JamisonHood/Haptic-Paddle/README.md

# Haptic-Paddle

The haptic paddle is a low cost haptic feedback device intended to be used in STEM education.
