JamisonHood/Haptic-Paddle/STEP Files/LCD Plate.step

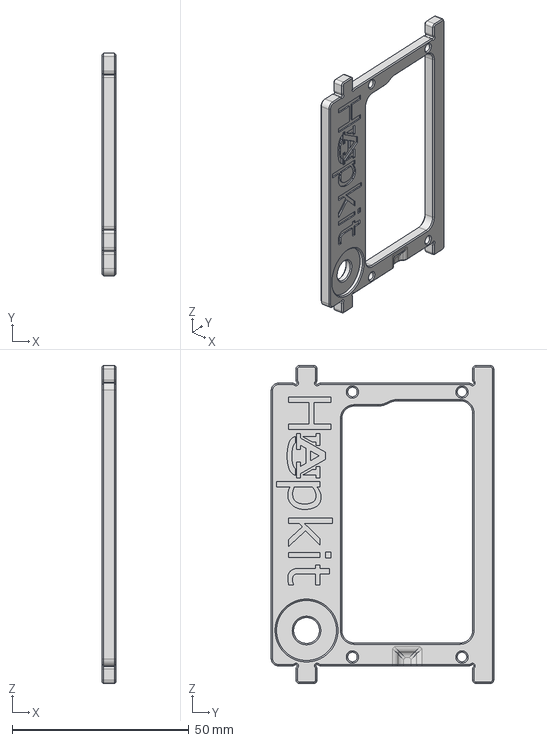
[picture p1: CAD file, 2023-11-12]
STEP Files/LCD Plate.step
4.00 x 63.0 x 90.0 mm
