JamisonHood/Haptic-Paddle/STEP Files/Left Side Plate.step

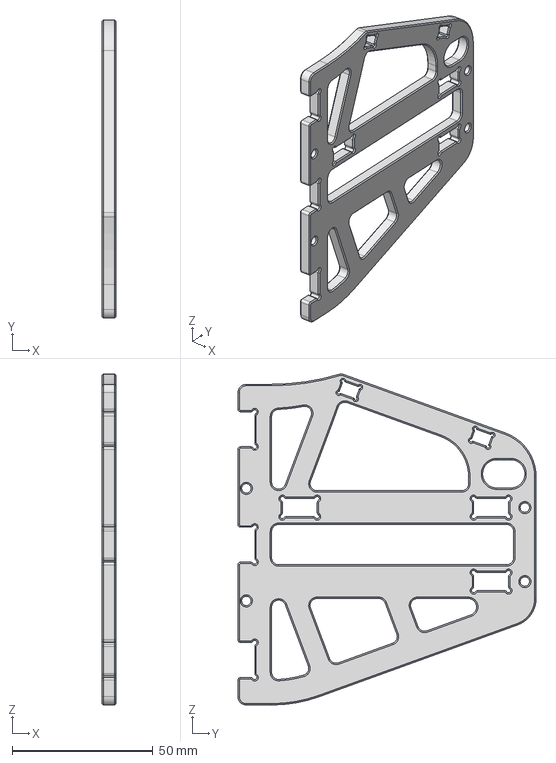
[picture p2: CAD file, 2023-11-12]
STEP Files/Left Side Plate.step
5.00 x 106.0 x 117.6 mm
