JamisonHood/Haptic-Paddle/STEP Files/Support Plate.step

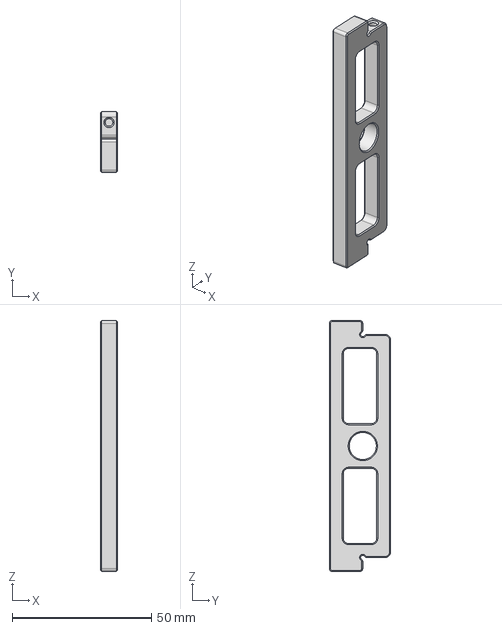
[picture p3: CAD file, 2023-11-12]
STEP Files/Support Plate.step
6.00 x 22.0 x 90.0 mm
