JamisonHood/Haptic-Paddle/STEP Files/Motor Plate (90 Deg).step

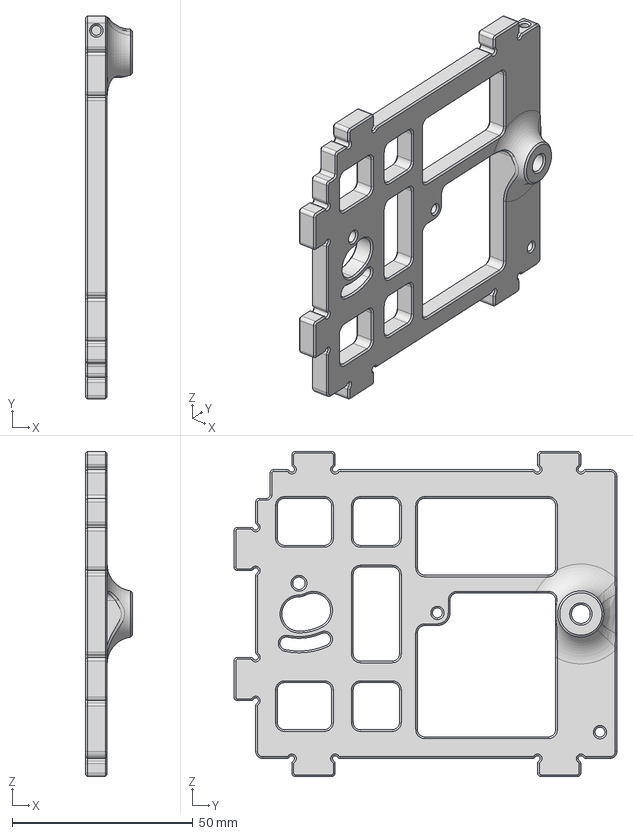
[picture p4: CAD file, 2023-11-12]
STEP Files/Motor Plate (90 Deg).step
13.0 x 106.0 x 90.0 mm
