JamisonHood/Haptic-Paddle/STEP Files/Motor Pulley.step

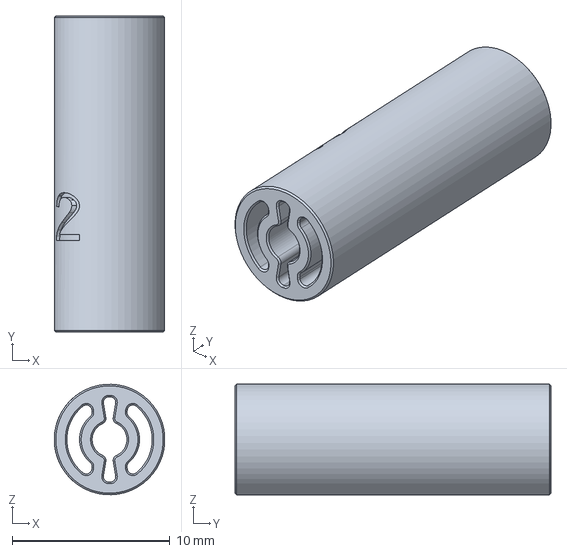
[picture p5: CAD file, 2023-11-12]
STEP Files/Motor Pulley.step
6.99 x 20.0 x 7.00 mm
