JamisonHood/Haptic-Paddle/STEP Files/Swing Arm.step

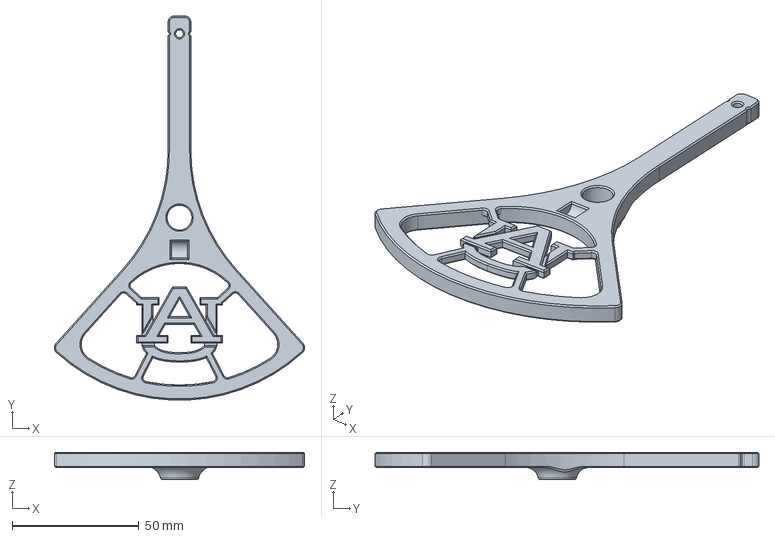
[picture p6: CAD file, 2023-11-12]
STEP Files/Swing Arm.step
98.7 x 151.4 x 10.8 mm
