JamisonHood/Haptic-Paddle/STEP Files/Bottom Plate.step

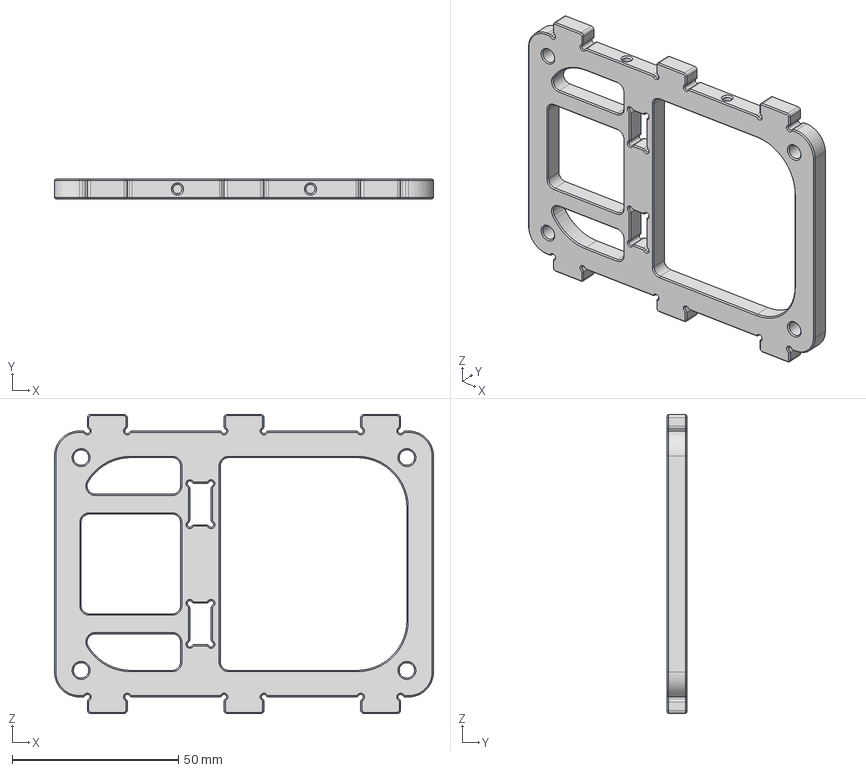
[picture p7: CAD file, 2023-11-12]
STEP Files/Bottom Plate.step
114.0 x 6.00 x 90.0 mm
