JamisonHood/Haptic-Paddle/STEP Files/Right Side Plate.step

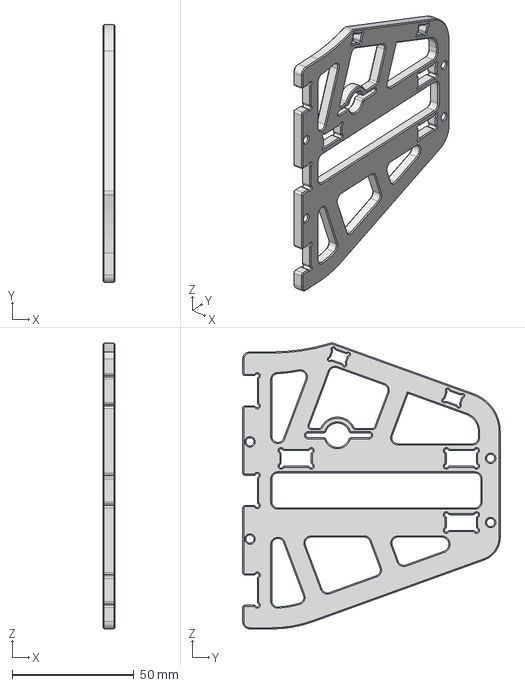
[picture p8: CAD file, 2023-11-12]
STEP Files/Right Side Plate.step
5.00 x 106.0 x 117.7 mm
