JamisonHood/Haptic-Paddle/Haptic Paddle Assembly Instructions.pdf

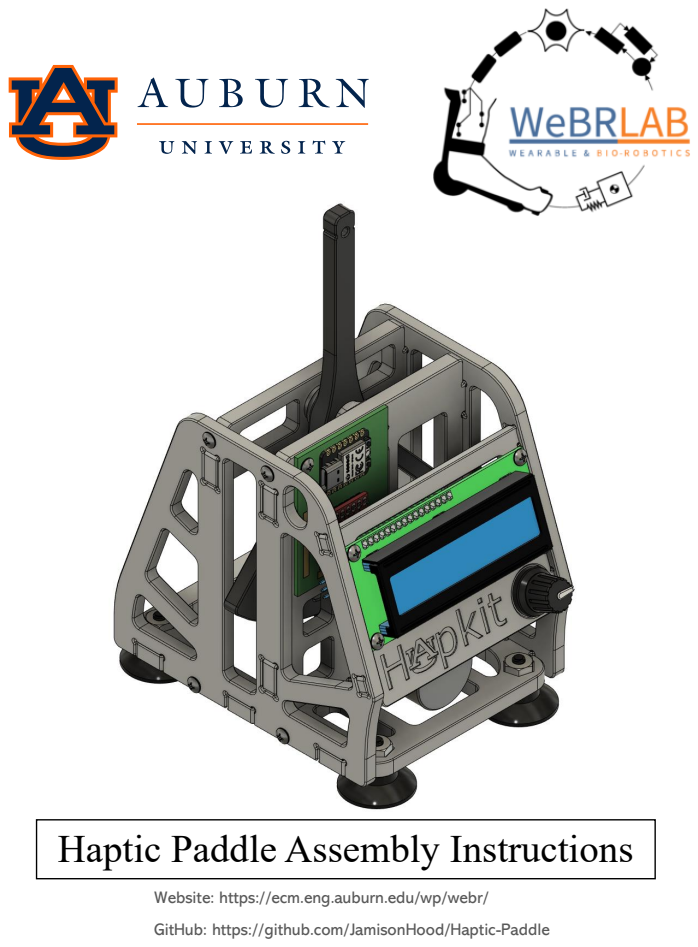
[picture p9: page 1]

Haptic Paddle Assembly Instructions

Website: https://ecm.eng.auburn.edu/wp/webr/

GitHub: https://github.com/JamisonHood/Haptic-Paddle

P a g e | 2

## Table of Contents

Required Components | 3
Electronics | 3
Hardware | 4
3D printed Components | 6
Assembly Steps | 9
1 | 9
2 | 9
3 | 10
4 | 10
5 | 11
6 | 11
7 | 12
8 | 12
9 | 13
10 | 13
11 | 14
12 | 14
13 | 15
14 | 15
15 | 16
16 | 16
17 | 17
18 | 17
19 | 18
20 | 18

## Required Components

## Electronics

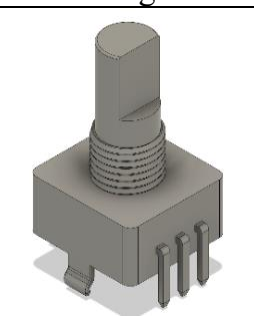
[picture p10: figure]

Part Name | Quantity | Image
Rotary Encoder | 1

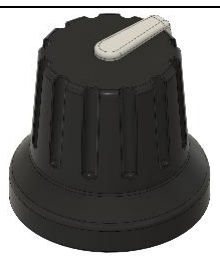
[picture p11: figure]

Encoder Knob | 1

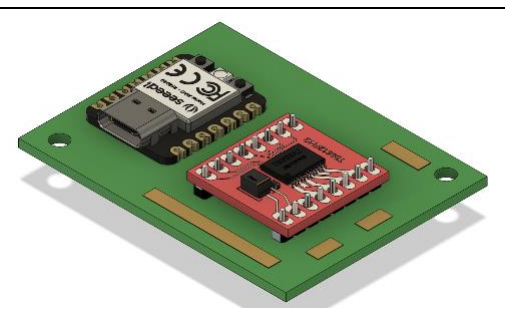
[picture p12: figure]

Control Board | 1

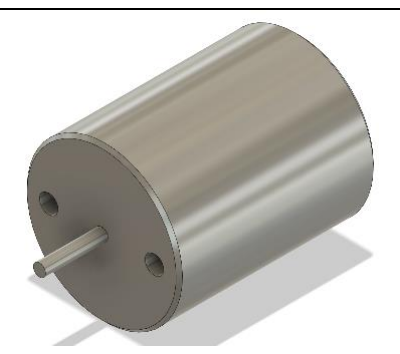
[picture p13: figure]

Brushed Motor | 1

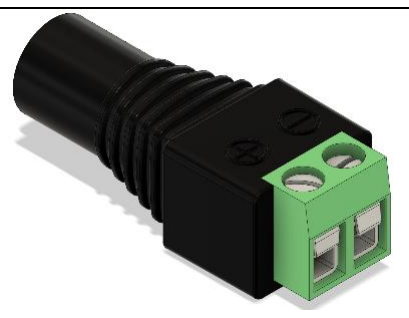
[picture p14: figure]

Barrel Power Connector | 1

LCD Display | 1

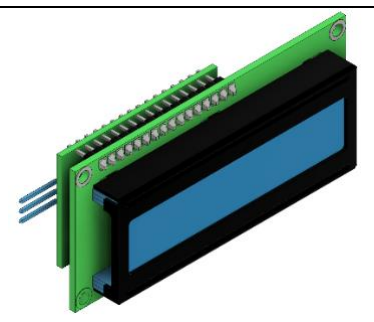
[picture p15: figure]

## Hardware

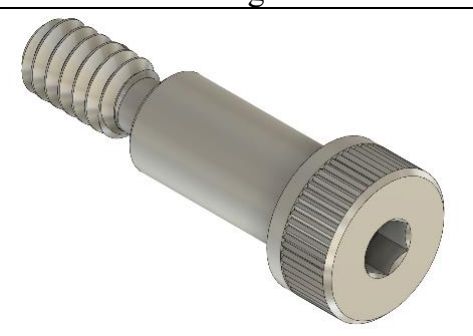
[picture p16: figure]

Part Name | Quantity | Image
¼ Inch Shoulder Bolt | 1

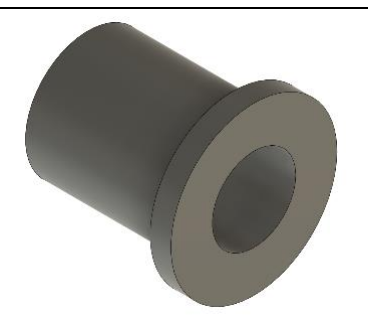
[picture p17: figure]

¼ Inch Sleeve Bushing | 1

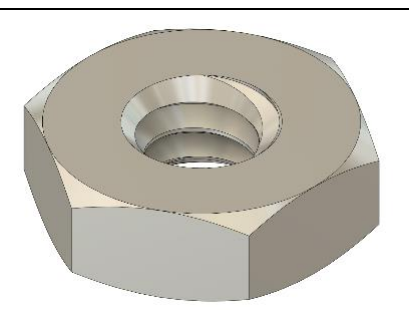
[picture p18: figure]

10-24 Nut (For Shoulder Bolt) | 1

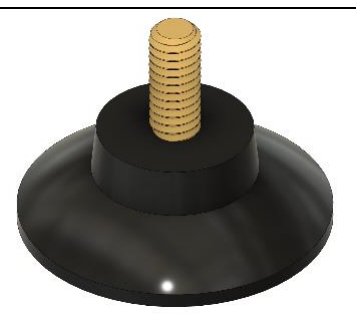
[picture p19: figure]

Rubber Feet | 4

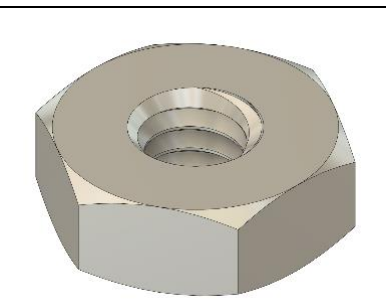
[picture p20: figure]

8-32 Nut (For Rubber Feet) | 4

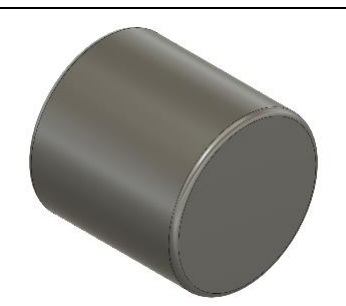
[picture p21: figure]

Disc Magnet | 1

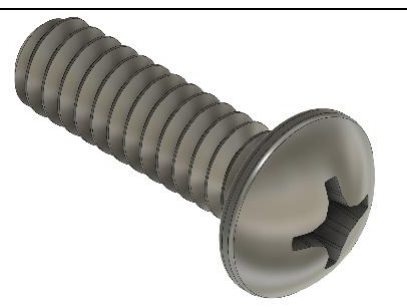
[picture p22: figure]

18-8 Pan Head Screw | 16

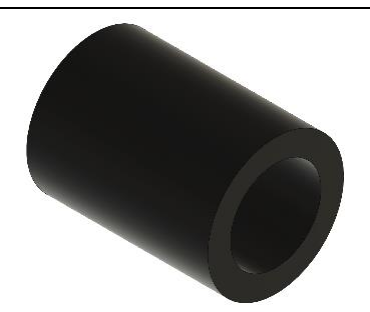
[picture p23: figure]

Rubber Sleeve | 1

## 3D printed Components

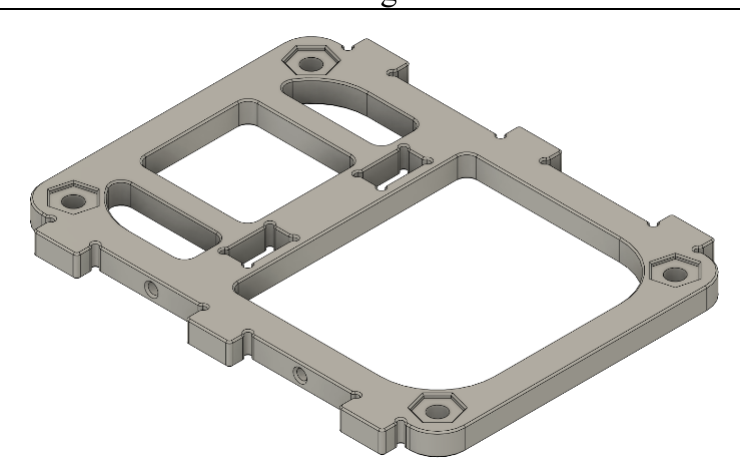
[picture p24: figure]

Part Name | Quantity | Image
Base Plate | 1

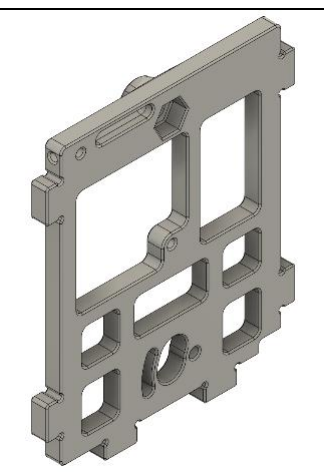
[picture p25: figure]

Motor and Electronics Plate | 1

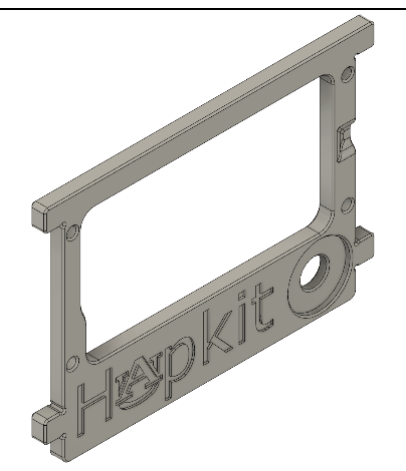
[picture p26: figure]

LCD Frame | 1

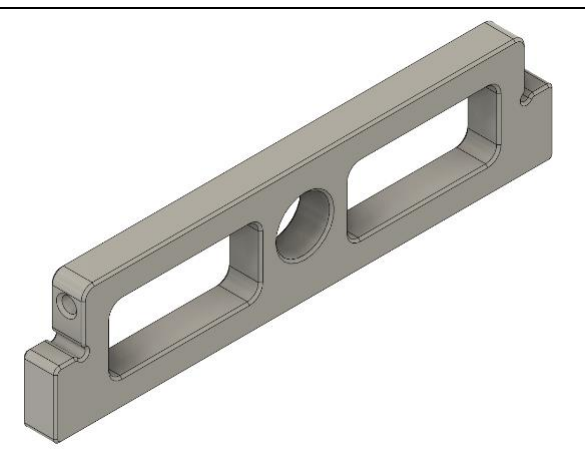
[picture p27: figure]

Shoulder Support Plate | 1

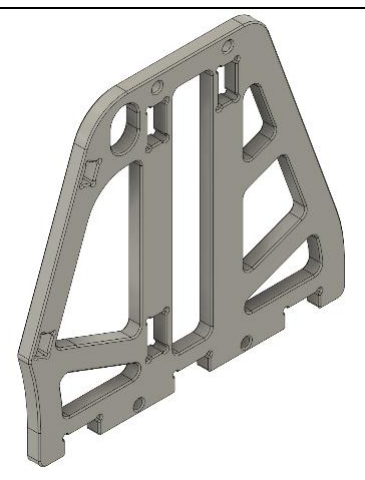
[picture p28: figure]

Left Side Plate | 1

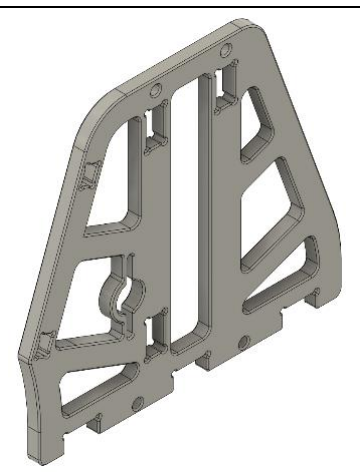
[picture p29: figure]

Right Side Plate | 1

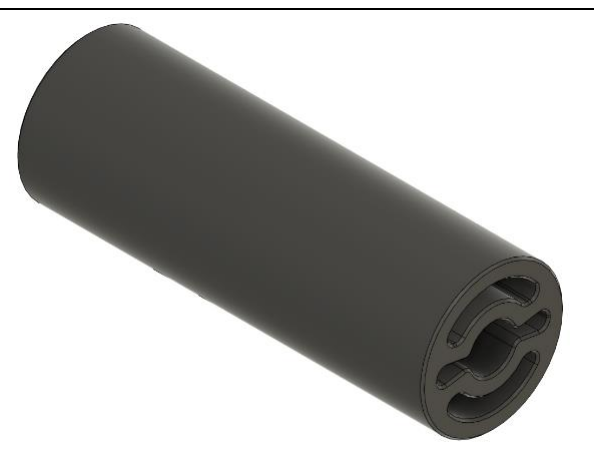
[picture p30: figure]

Motor Pulley | 1

P a g e |

8

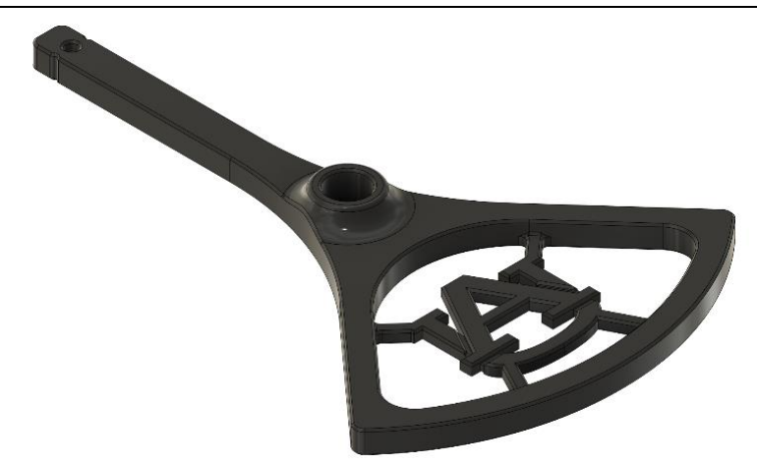
[picture p31: figure]

Paddle
1

1 | Assembly Steps

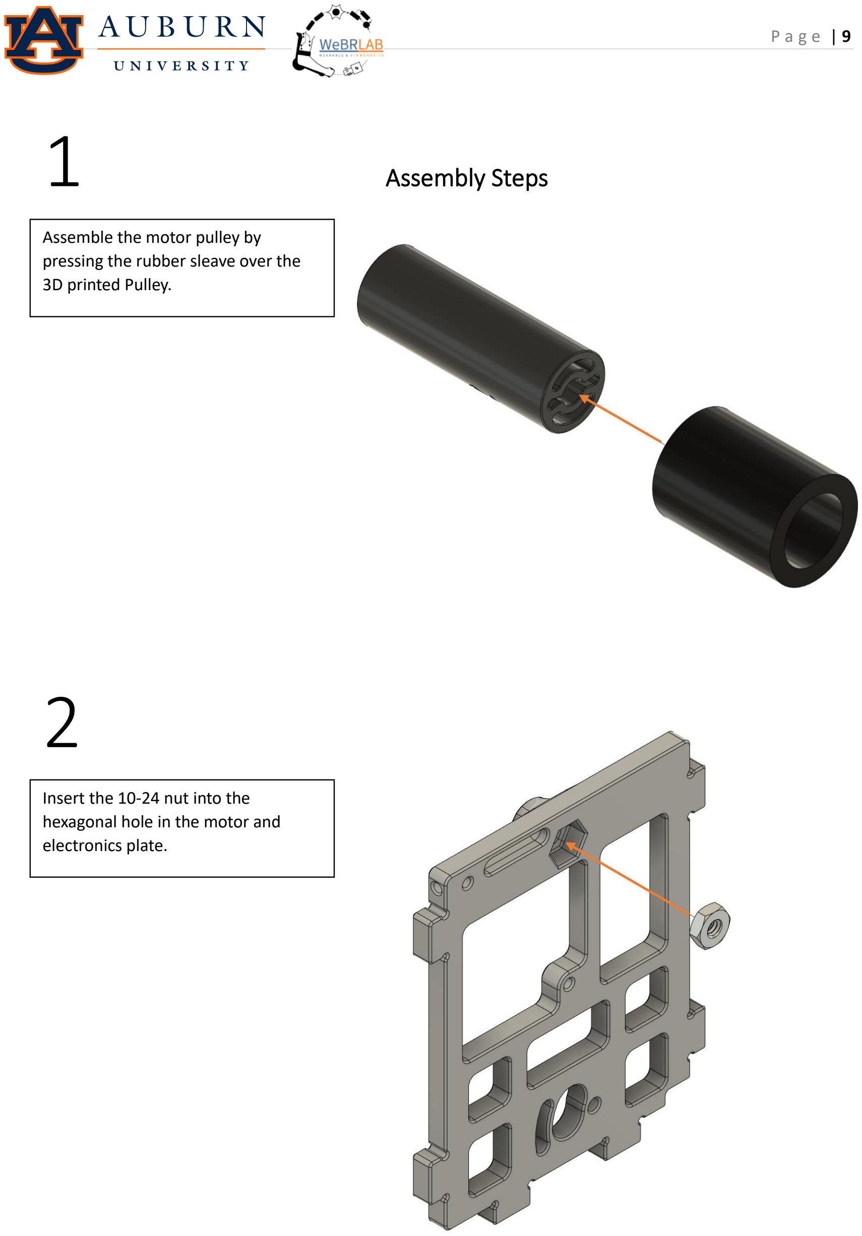
[picture p32: page 9]

2

Assemble the motor pulley by pressing the rubber sleave over the 3D printed Pulley.

Insert the 10-24 nut into the hexagonal hole in the motor and electronics plate.

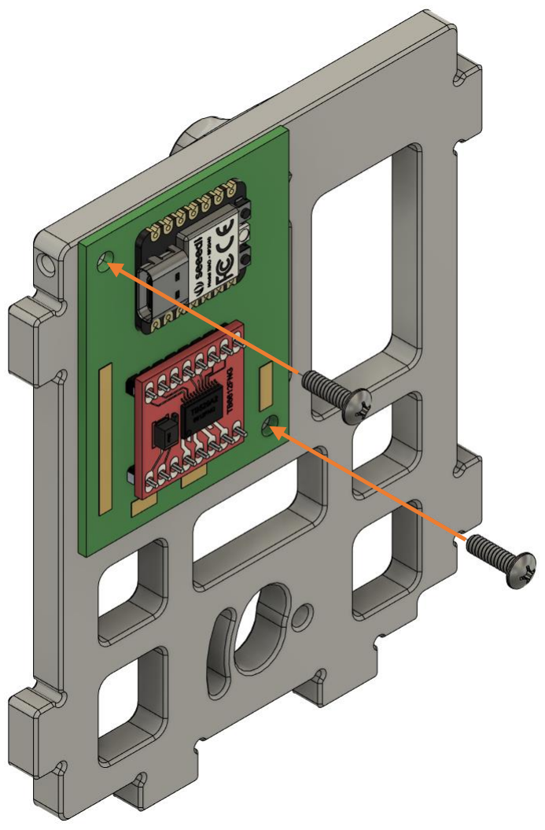
[picture p33: figure]

3

4

Attach the electronics PCB using 2 #18-8 Screws.

Note: Make sure the #10-24 nut is in place as it will not be accessible after this step.

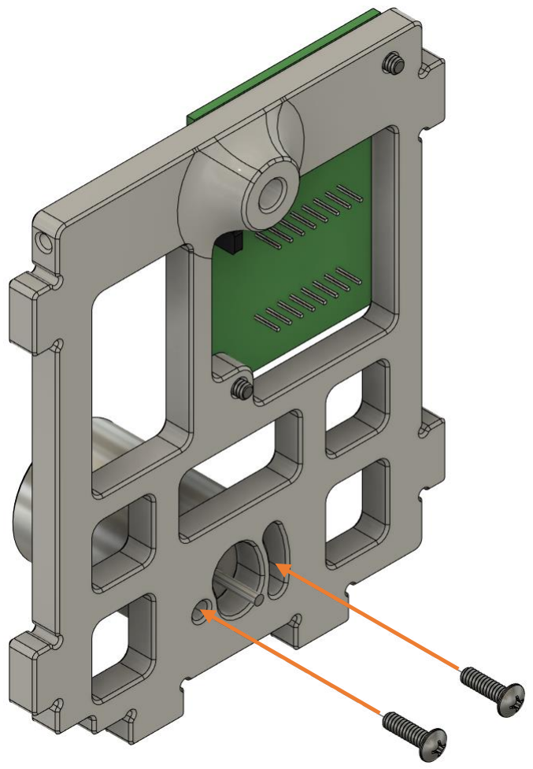
[picture p34: figure]

Attach the brushed motor using 2 #18-8 screws. Leave the screws loose such that the motor can freely swing in its mount.

5

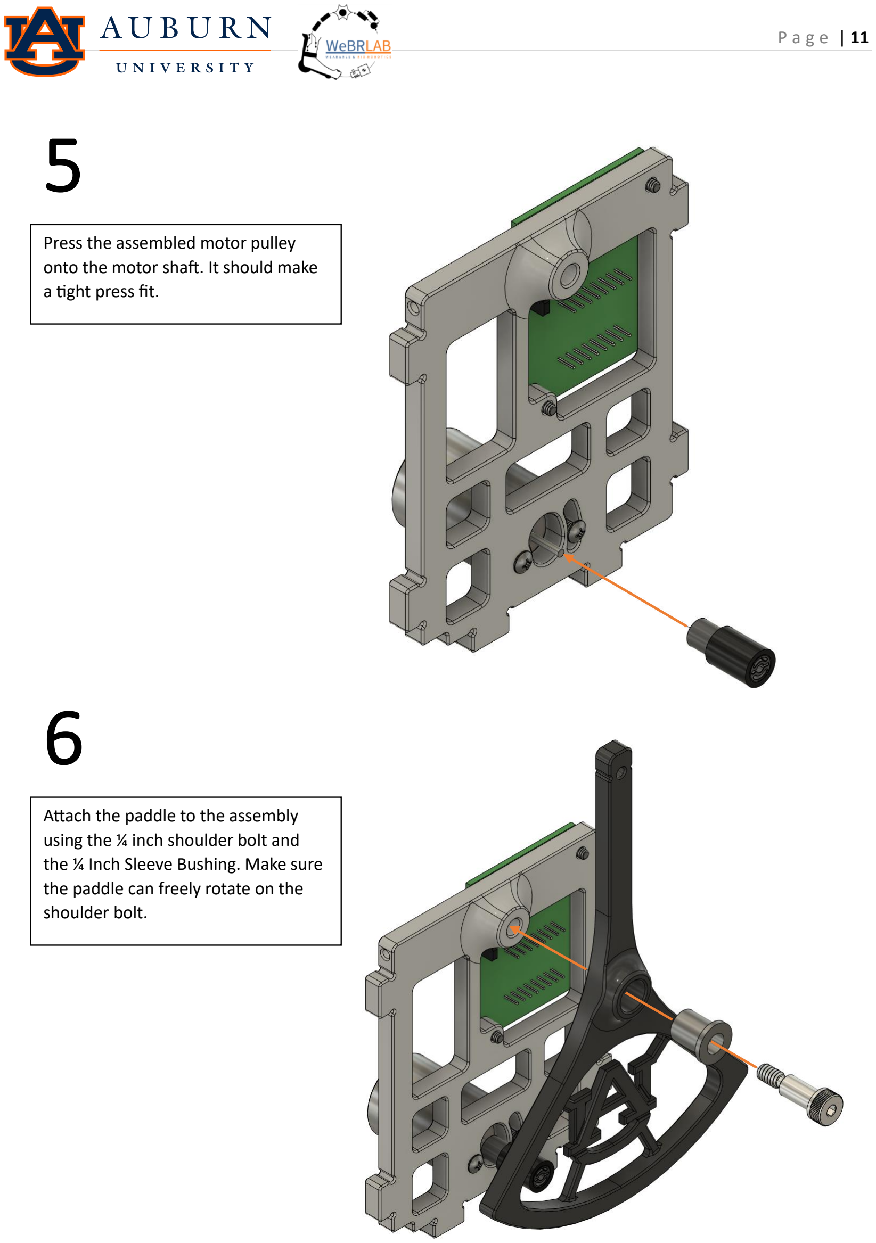
[picture p35: page 11]

6

Press the assembled motor pulley onto the motor shaft. It should make a tight press fit.

Attach the paddle to the assembly using the ¼ inch shoulder bolt and the ¼ Inch Sleeve Bushing. Make sure the paddle can freely rotate on the shoulder bolt.

7

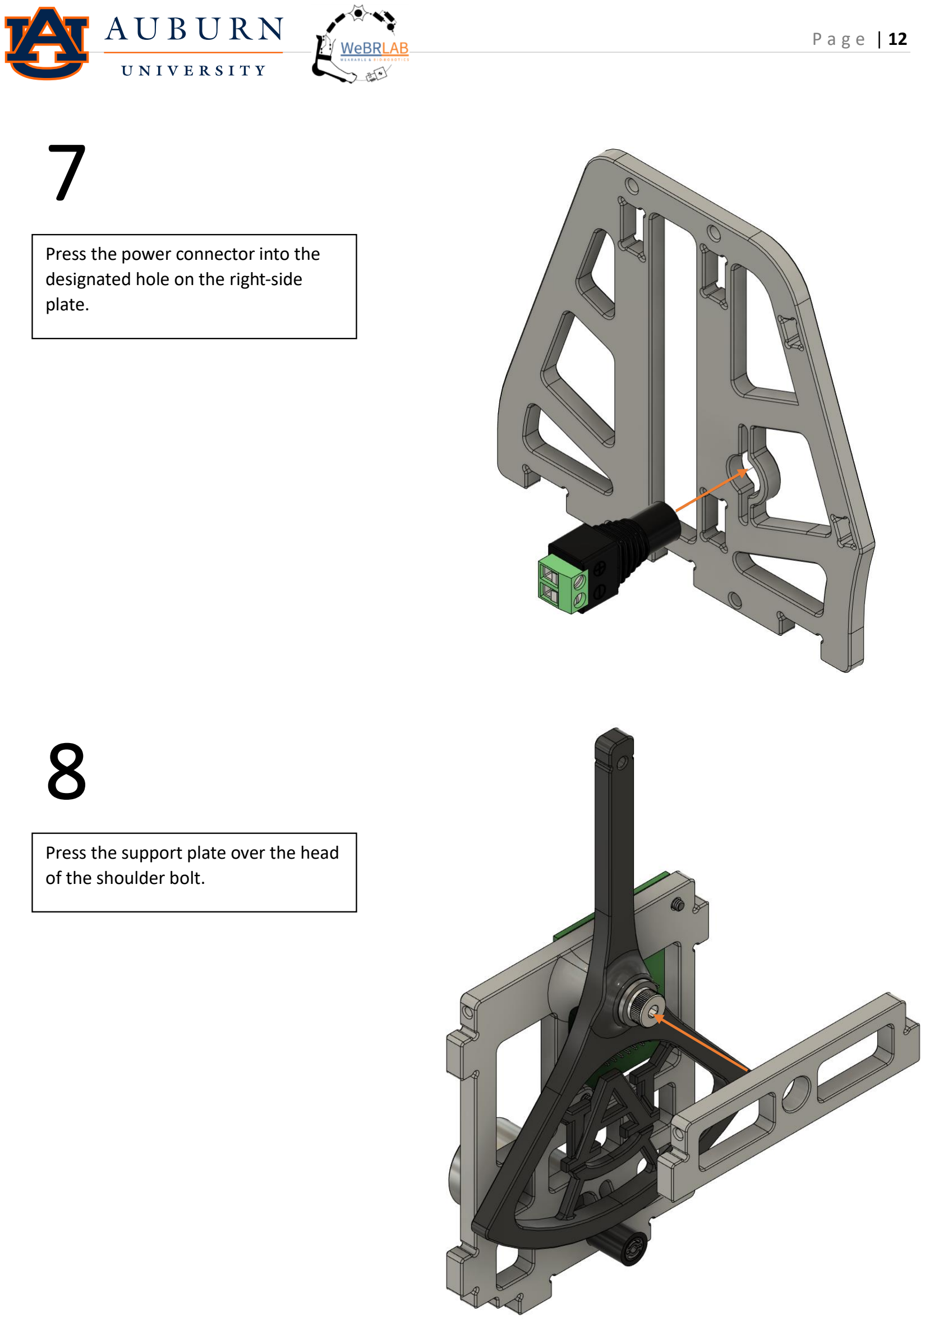
[picture p36: page 12]

8

Press the power connector into the designated hole on the right-side plate.

Press the support plate over the head of the shoulder bolt.

9

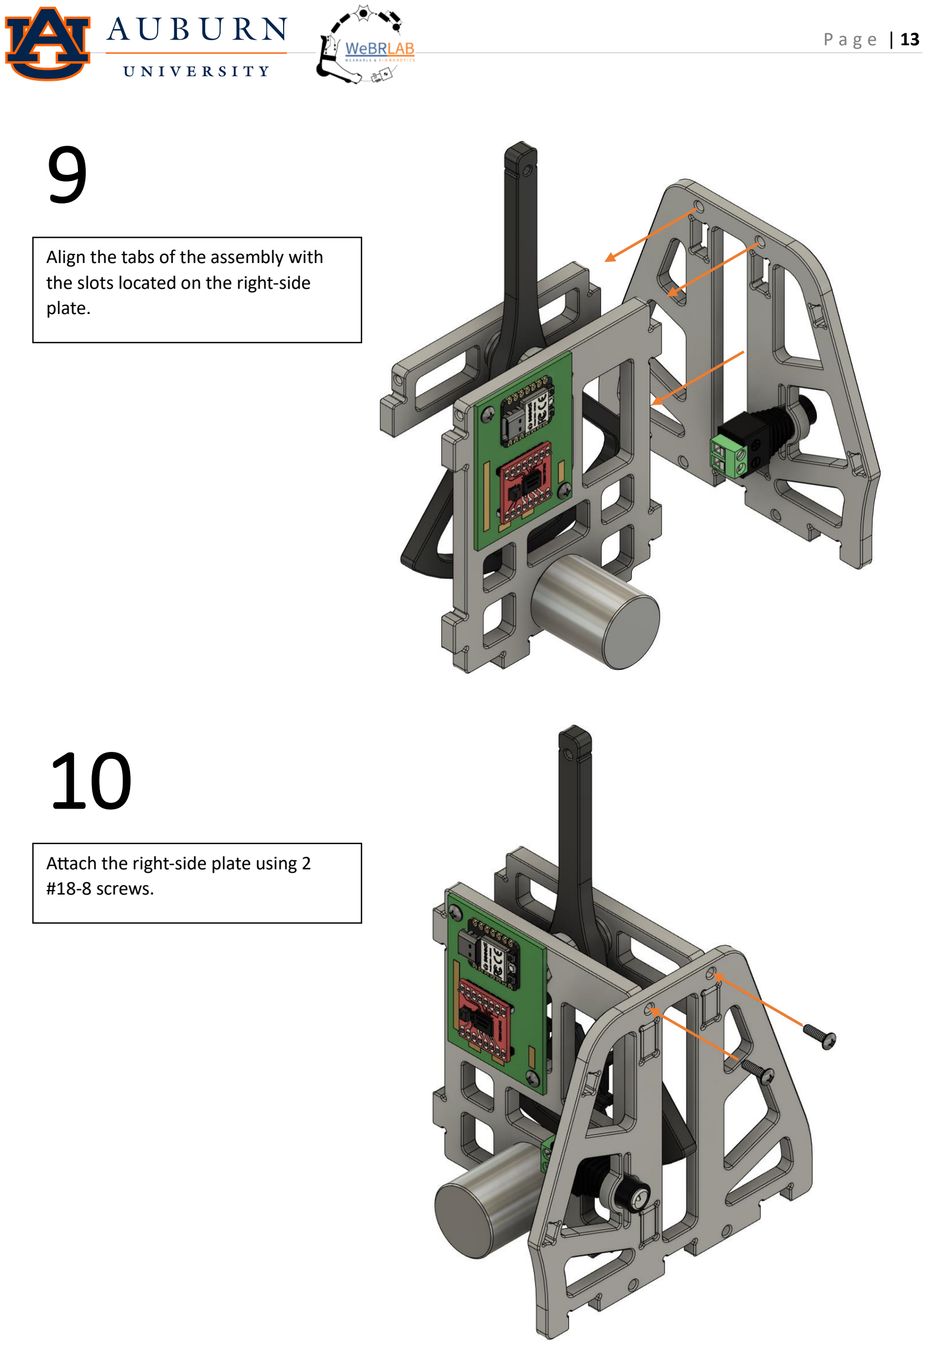
[picture p37: page 13]

10

Align the tabs of the assembly with the slots located on the right-side plate.

Attach the right-side plate using 2 #18-8 screws.

11

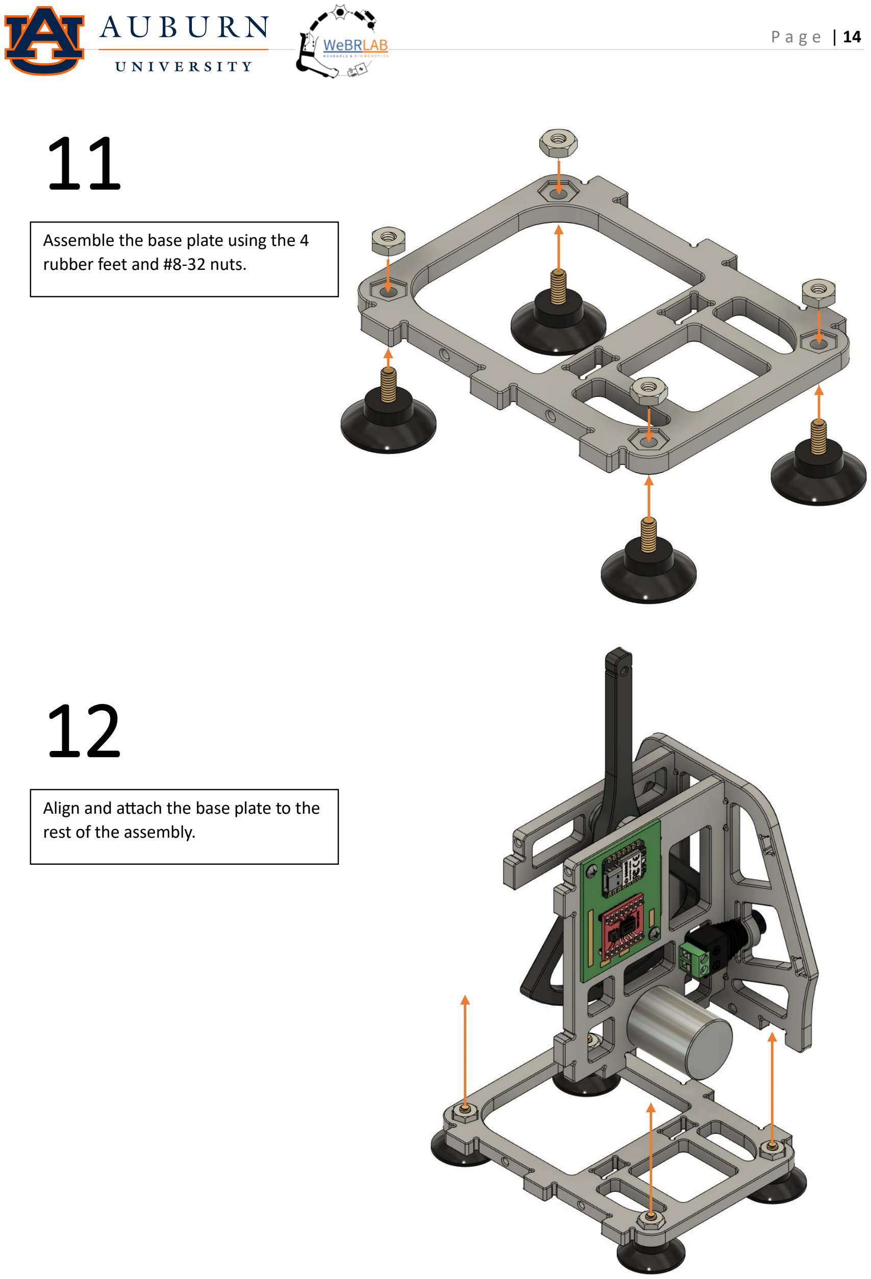
[picture p38: page 14]

12

Assemble the base plate using the 4 rubber feet and #8-32 nuts.

Align and attach the base plate to the rest of the assembly.

13

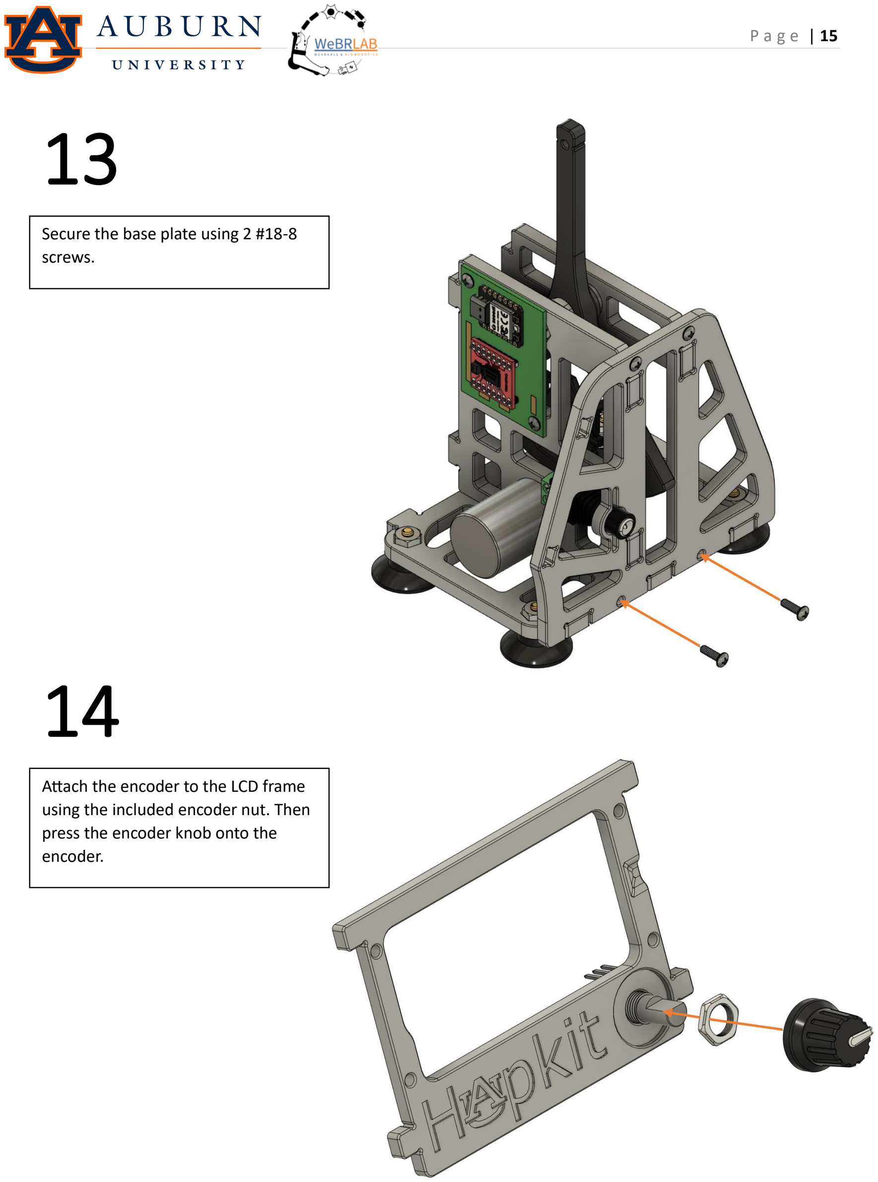
[picture p39: page 15]

14

Secure the base plate using 2 #18-8 screws.

Attach the encoder to the LCD frame using the included encoder nut. Then press the encoder knob onto the encoder.

15

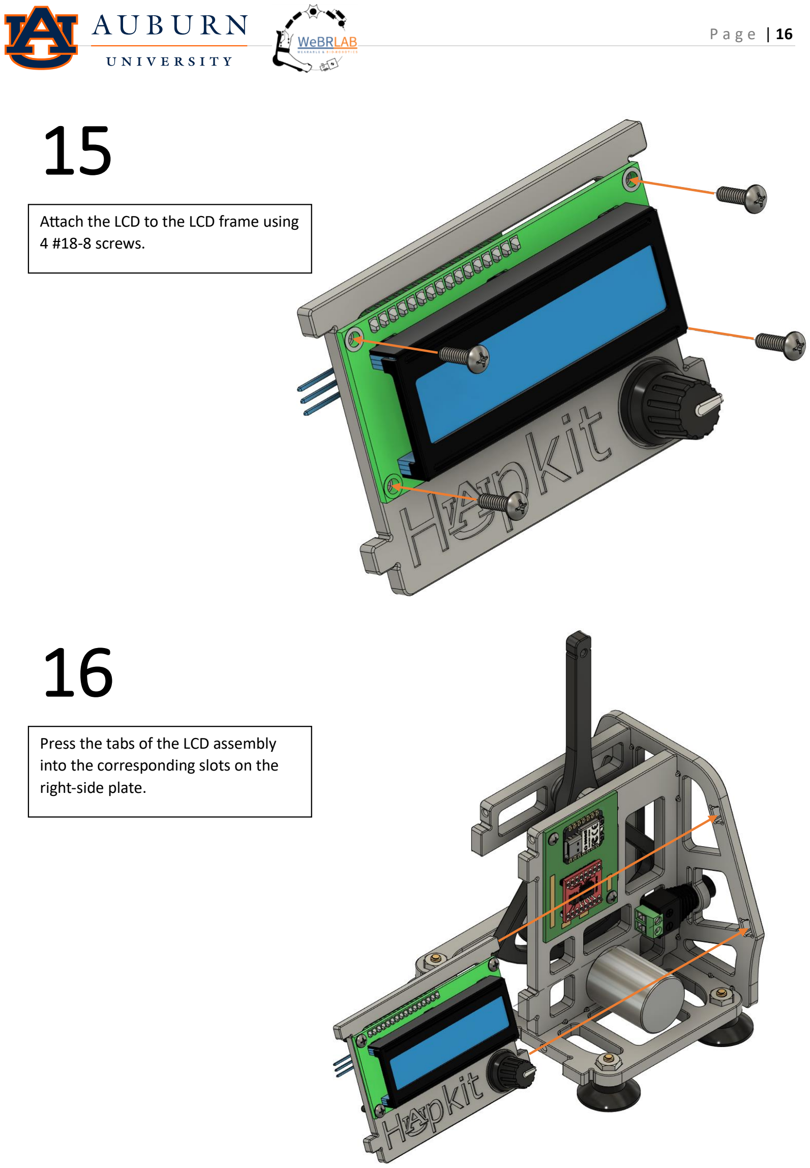
[picture p40: page 16]

16

Attach the LCD to the LCD frame using 4 #18-8 screws.

Press the tabs of the LCD assembly into the corresponding slots on the right-side plate.

17

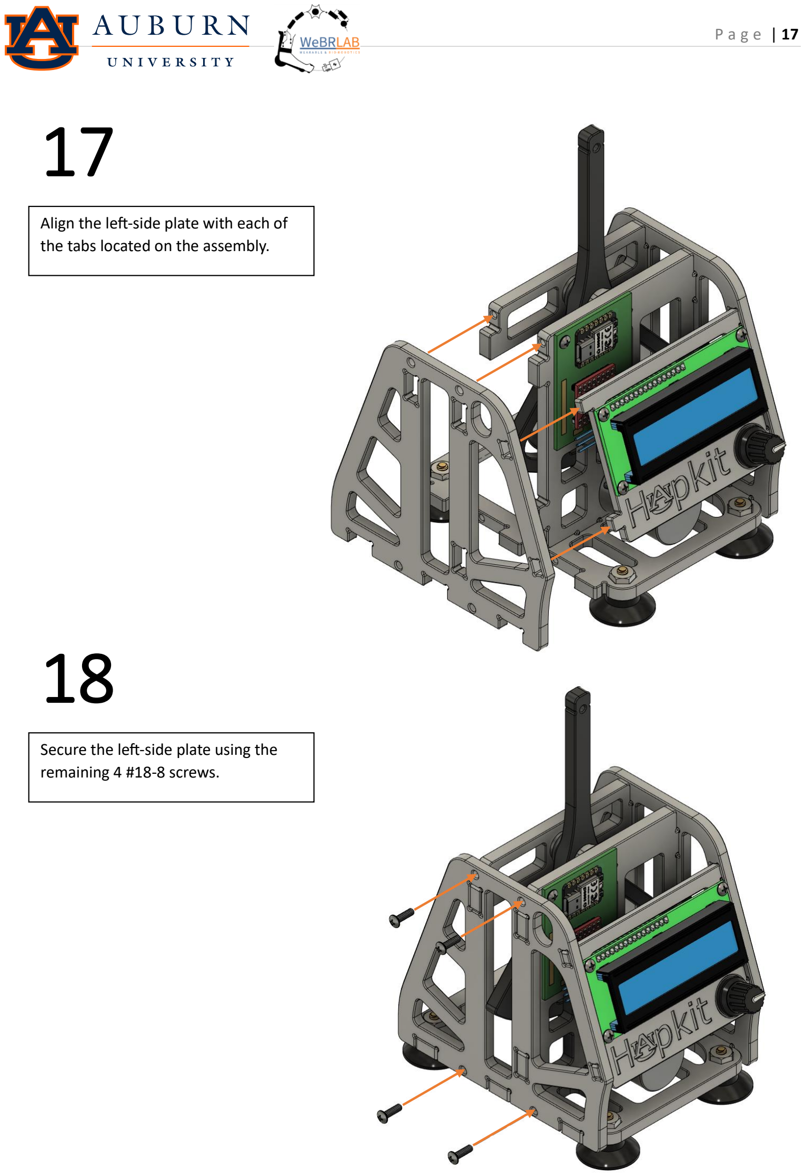
[picture p41: page 17]

18

Align the left-side plate with each of the tabs located on the assembly.

Secure the left-side plate using the remaining 4 #18-8 screws.

19

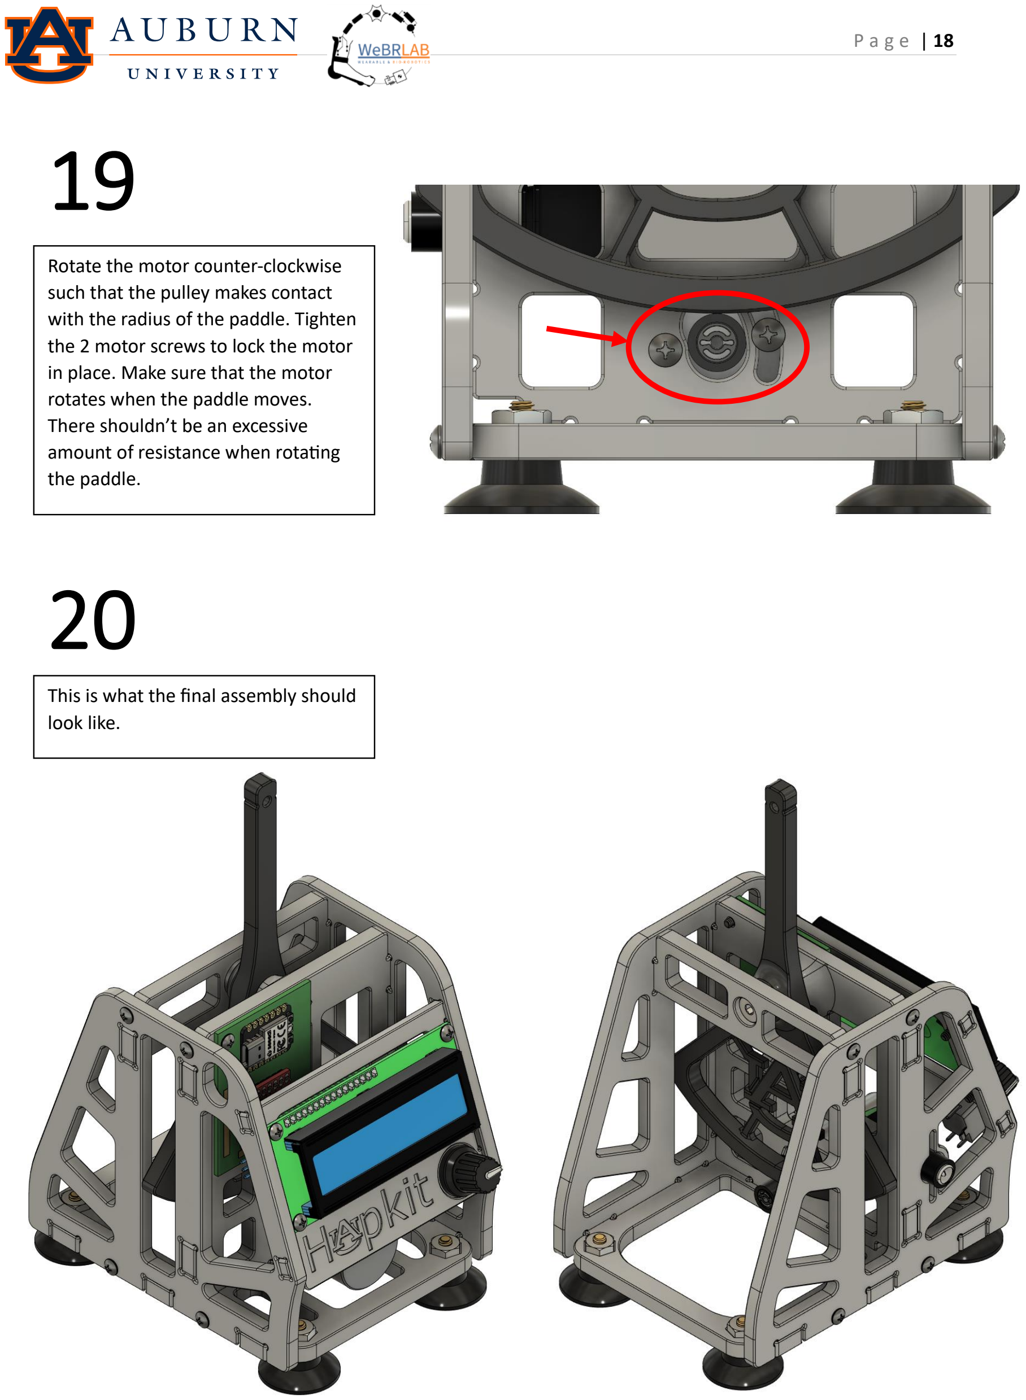
[picture p42: page 18]

Rotate the motor counter

-clockwise
such that the pulley makes contact with the radius of the paddle. Tighten the 2 motor screws to lock the motor in place. Make sure that the motor rotates when the paddle moves. There shouldn’t be an excessive amount of resistance when rotating the paddle.
20

This is what the final assembly should look like.
