JamisonHood/Haptic-Paddle/(commit log)

2023-11-12 Added CAD Files
    [Bottom Plate.step, LCD Plate.step, Left Side Plate.step, Motor Plate (90 Deg).step, Motor Pulley.step, Right Side Plate.step, Support Plate.step, Swing Arm.step]
2023-11-12 Added Assembly Instructions
